PrBelamine/desk-watch-joy-teacher/docs/photos/four_parts.jpg

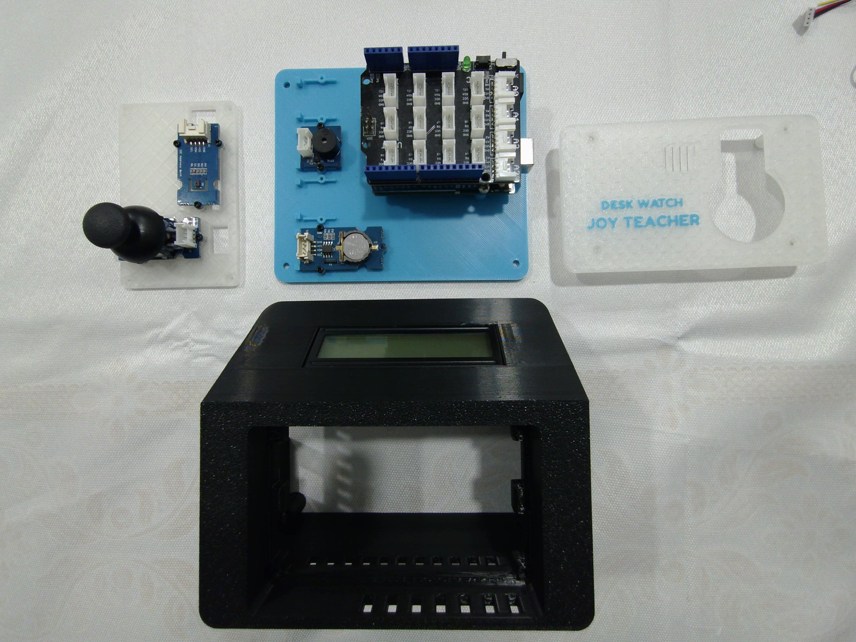
docs/photos/four_parts.jpg
