PrBelamine/desk-watch-joy-teacher/docs/photos/assembled_front.jpg

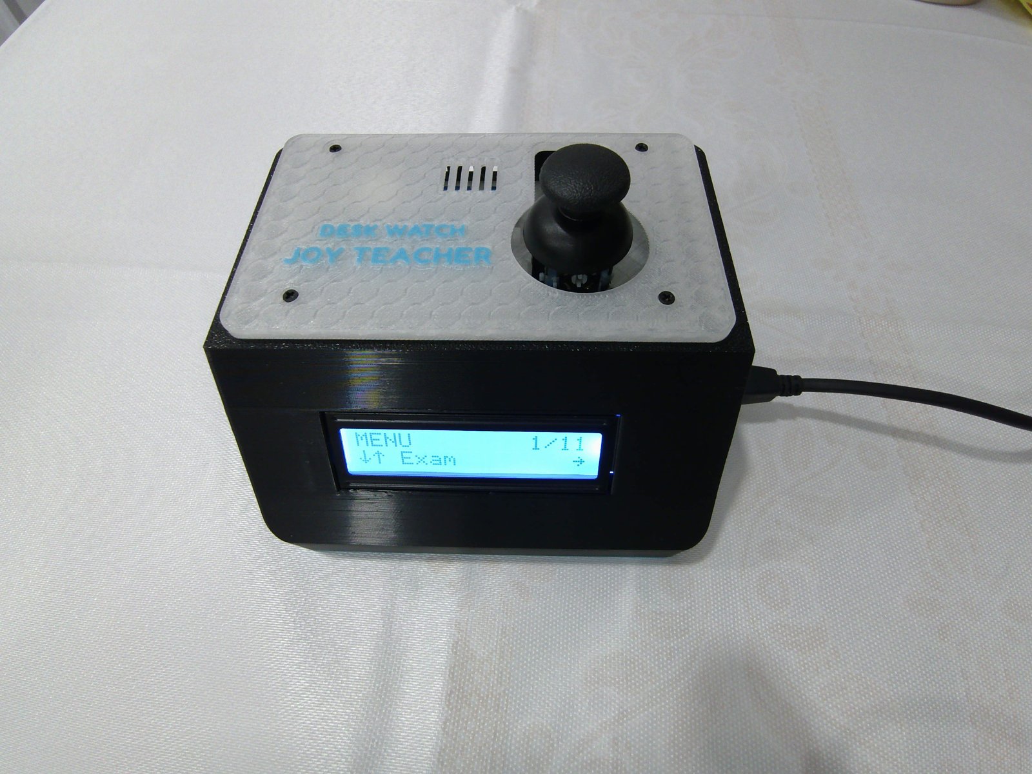
docs/photos/assembled_front.jpg
