PrBelamine/desk-watch-joy-teacher/docs/photos/assembled_side.jpg

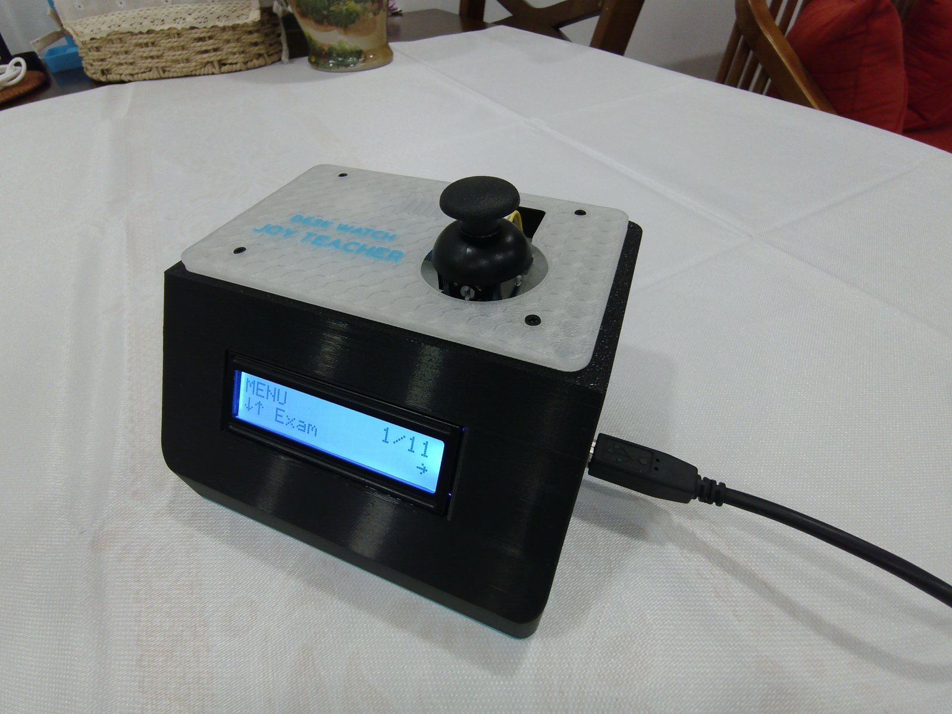
docs/photos/assembled_side.jpg
