PrBelamine/desk-watch-joy-teacher/docs/wiring_EN.png

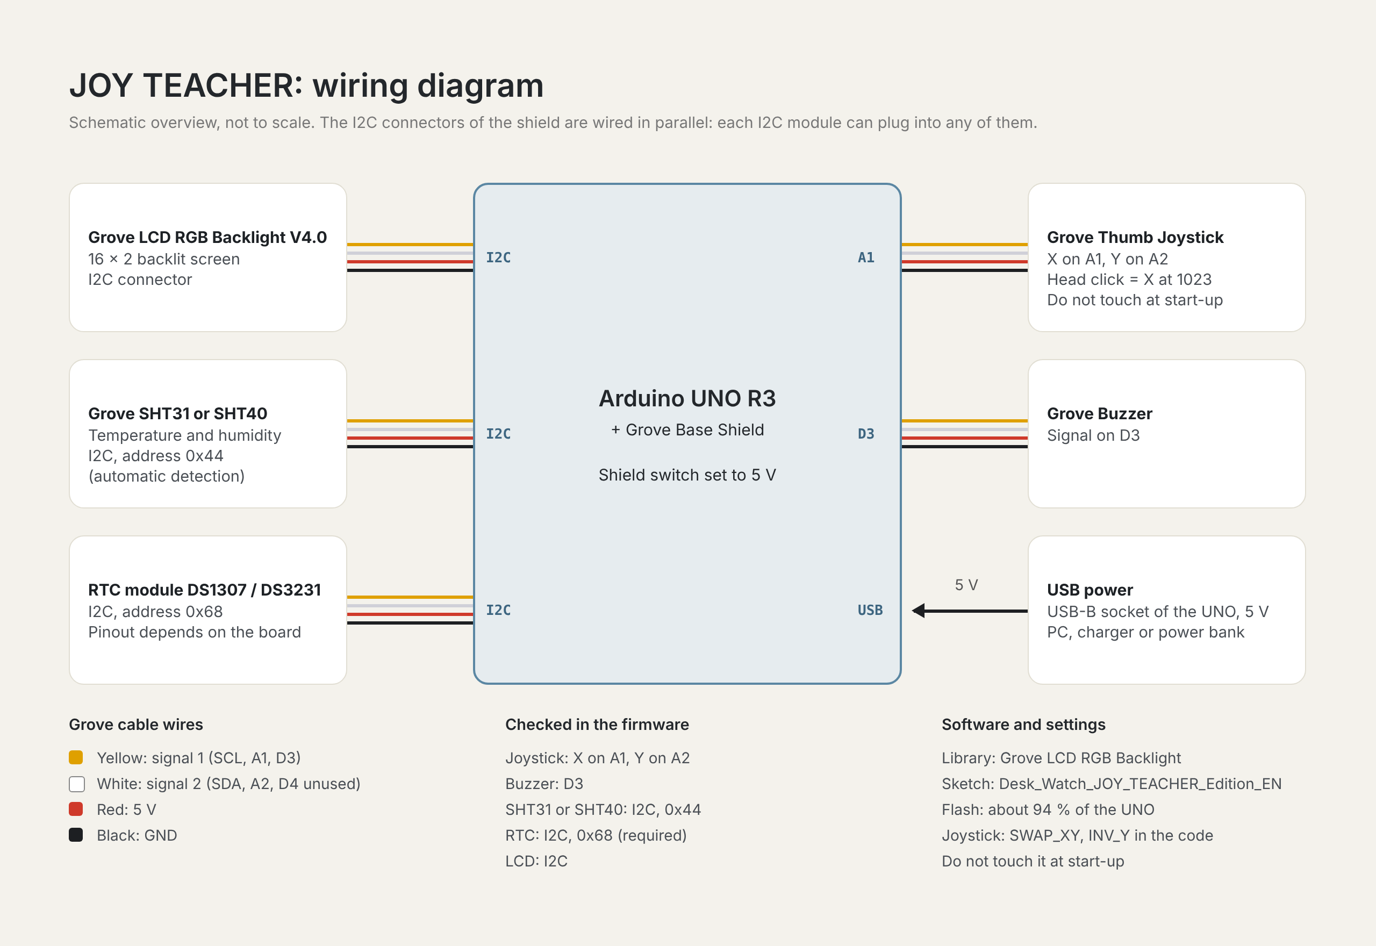
docs/wiring_EN.png
