PrBelamine/desk-watch-joy-teacher/docs/wiring_FR.png

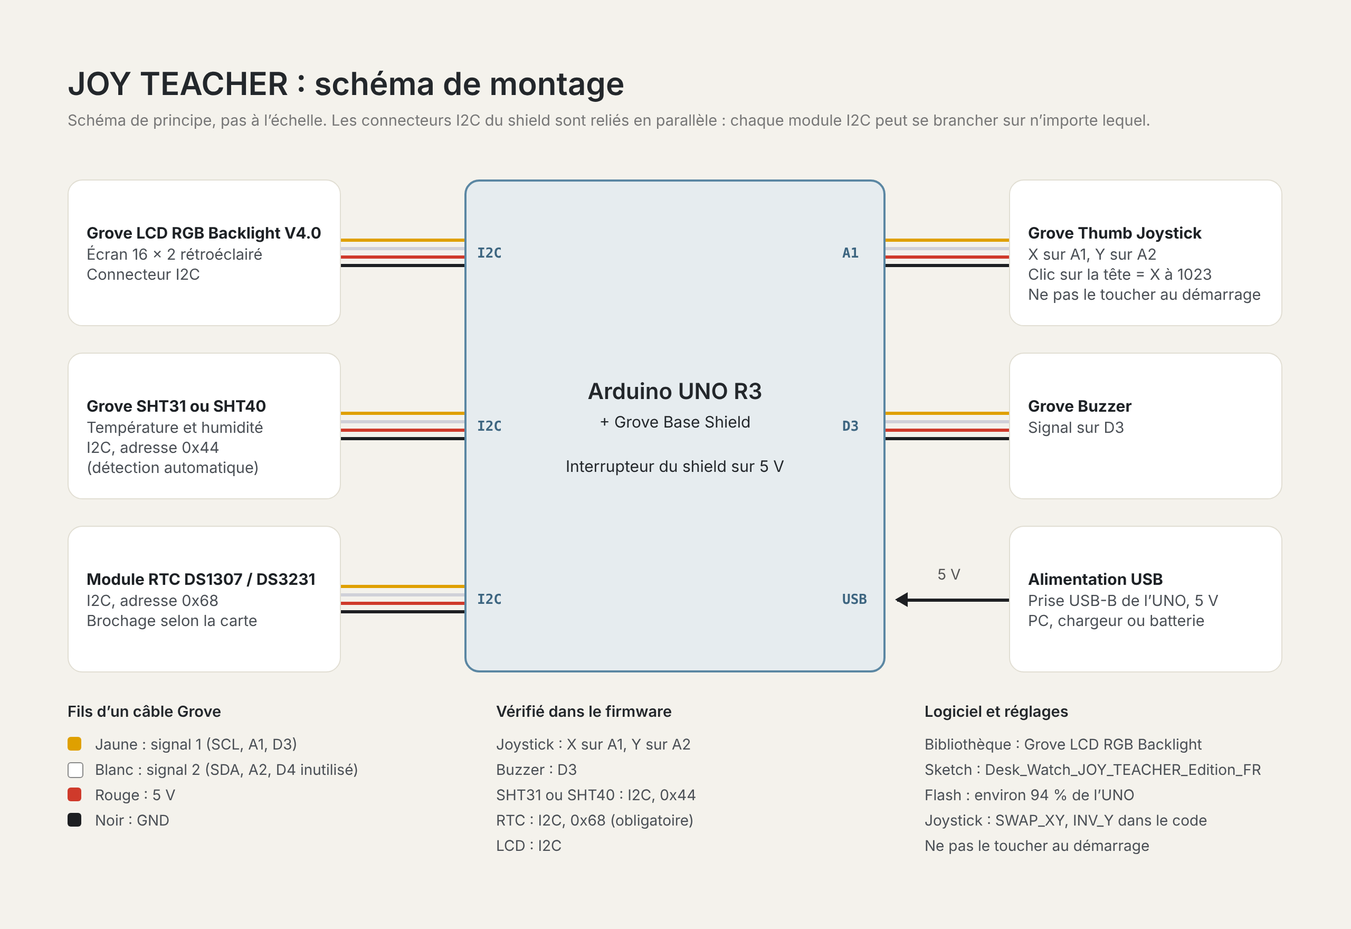
docs/wiring_FR.png
